eroslon6661/KWT/KWT_delivery_support/evidence/original_vcs_pass_terminal.png

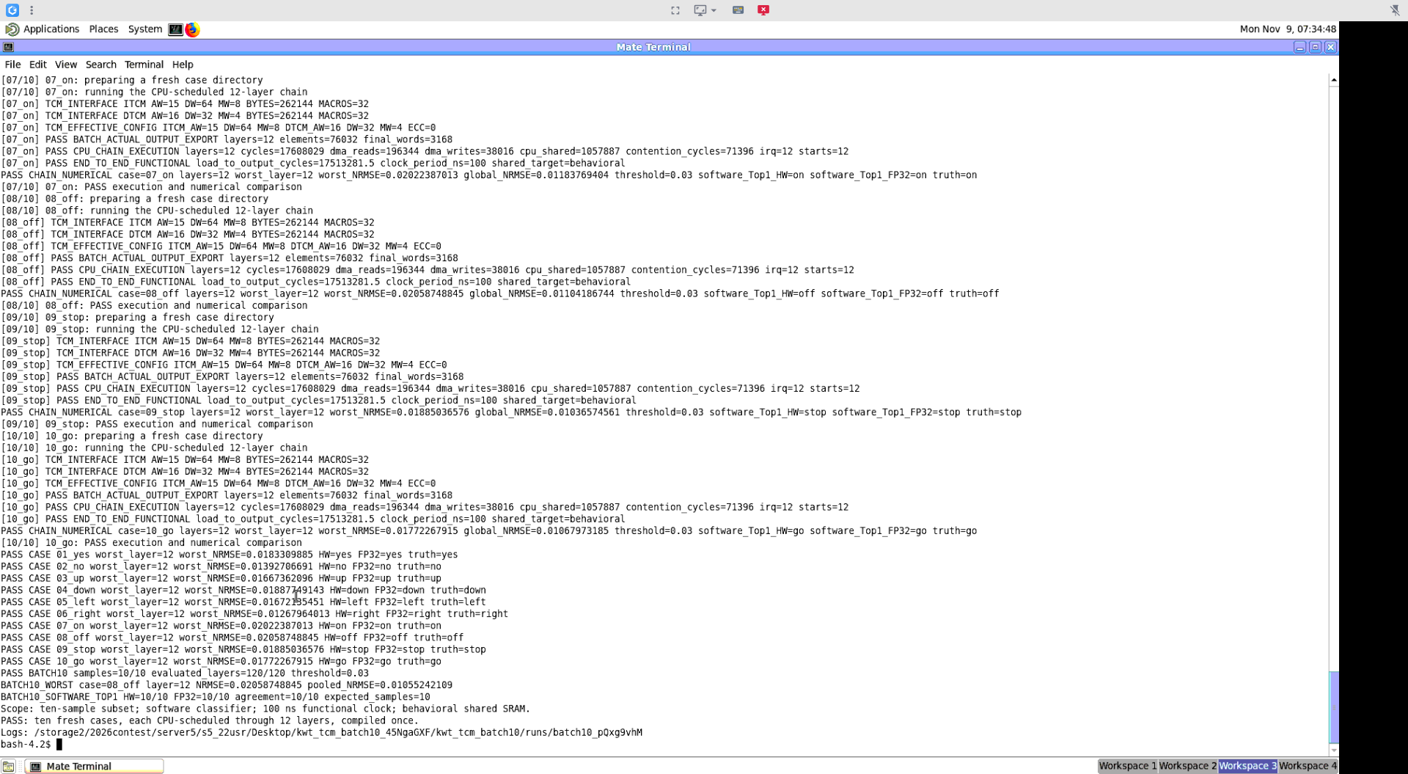
KWT_delivery_support/evidence/original_vcs_pass_terminal.png
