eroslon6661/KWT/KWT_delivery_support/evidence/server_recheck_terminal.png

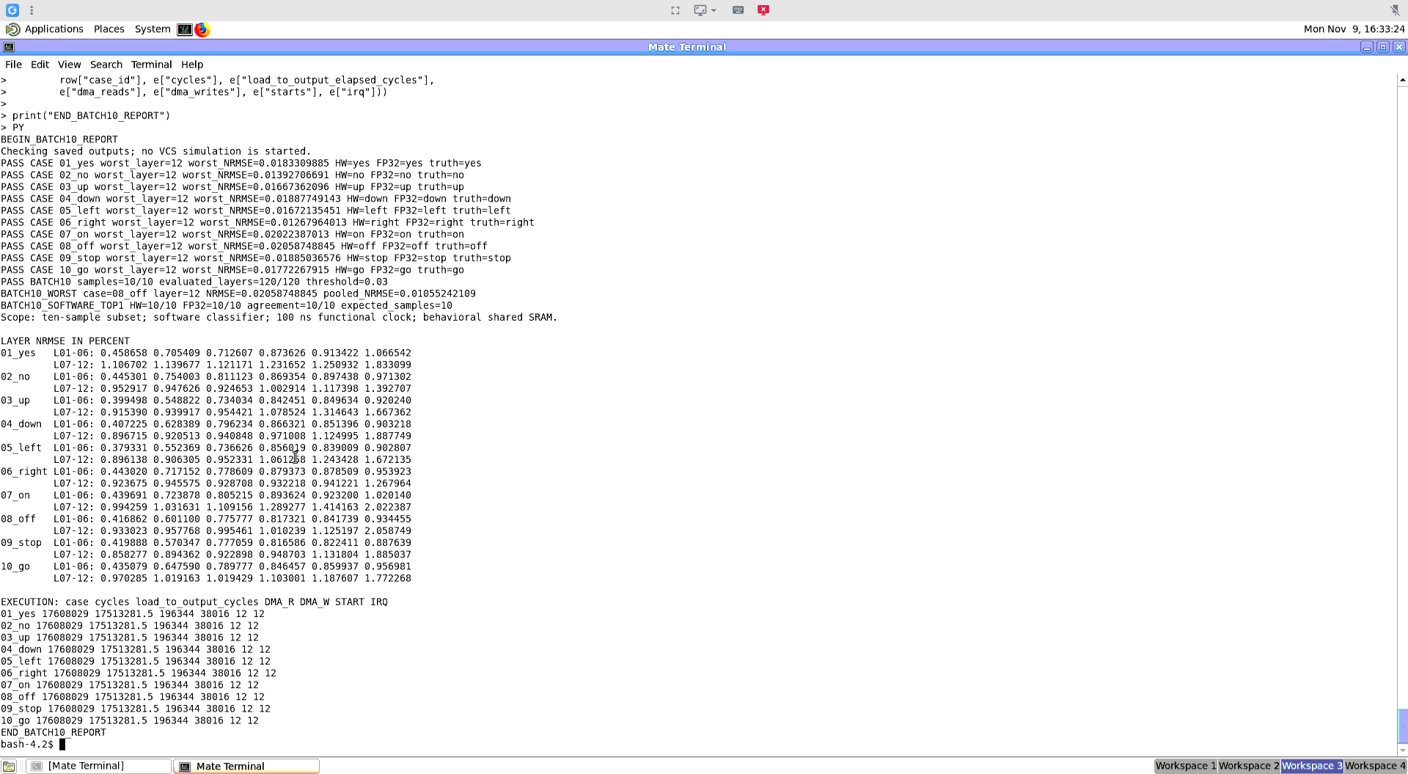
KWT_delivery_support/evidence/server_recheck_terminal.png
